xyzroe/Zintercom/images/z2m.png

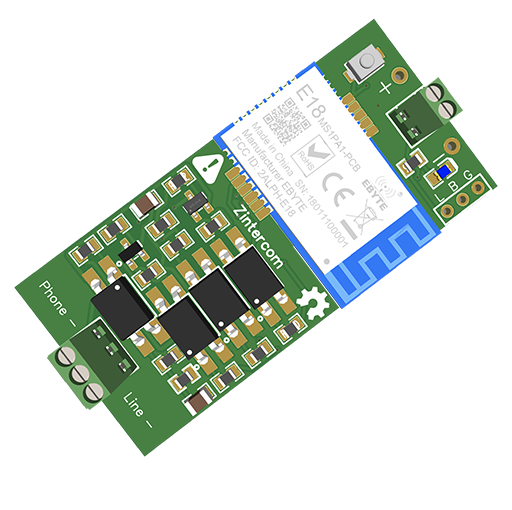
images/z2m.png
