xyzroe/Zintercom/hardware/BOM_Zintercom.csv

ID | Name | Designator | Footprint | Quantity | Manufacturer Part | Manufacturer | Supplier | Supplier Part | LCSC Assembly
1 | 22uF | C4 | CAP-SMD_L3.2-W1.6 | 1 | TCJR106M006R0500E | AVX | LCSC | C516053
2 | 10uF | C3 | CAP-SMD_L3.2-W1.6 | 1 | TCJR106M006R0500E | AVX | LCSC | C516053
3 | 120K | R12 | 0805 | 1 | RC0805FR-07120KL | YAGEO | LCSC | C114524
4 | BC817.215 | Q1 | SOT-23(SOT-23-3) | 1 | BC817,215 | Nexperia | LCSC | C8658
5 | 1K | R13 | R0805 | 1 | WR08X102JTL | WALSIN | LCSC | C163967
6 | 200K | R3 | R0805 | 1 | RC0402FR-07100KL | YAGEO | LCSC | C60491
7 | 470 | R4,R10,R11 | 0805 | 3 | RC0805FR-07470RL | YAGEO | LCSC | C114564
8 | 100 | R7 | 0805 | 1 | RC0805FR-07470RL | YAGEO | LCSC | C114564
9 | 10k | R2,R1 | 0805 | 2 | RC0805FR-07470RL | YAGEO | LCSC | C114564
10 | 50 | R6 | 0805 | 1 | RS-05K510JT | FH | LCSC | C139859
11 | KF128-2.54-3P | X1 | CONN-TH_3P-P2.54_KF128-2.54-3P | 1 | KF128-2.54-3P | Cixi Kefa Elec | LCSC | C474921
12 | LTV-817S-TA1-C | U2,U3,U4,U1 | OPTO-SMD-4_L4.6-W6.5-P2.54-LS10.3-BL | 4 | LTV-817S-TA1-C | LITEON | LCSC | C109227
13 | E18-MS1-PCB_domophone | E1 | E18-MS1PA1-PCB_DOMOPHONE | 1 | E18-MS1-PCB | Chengdu Ebyte Elec Tech | LCSC | C97344
14 | T.Switch3x4x2 | BTN | SWITCH-3.0*4.0 | 1 | T.Switch3x4x2 | ReliaPro |  | C26638
15 | AMS1117-3.3 | U5 | SOT-223-3_L6.5-W3.4-P2.30-LS7.0-BR | 1 | AMS1117-3.3 | AMS | LCSC | C6186 | Yes
16 | AAA HOLDER | B2 | AAA_HOLDER_NO_HOLE | 1
17 | 1u | C2,C1 | 0805 | 2
18 | KF128-2.54-2P | X2_0 | CONN-TH_P2.54_KF128-2.54-2P | 1 | KF128-2.54-2P | Cixi Kefa Elec | LCSC | C474920
19 | 2.54_5PIN | X3 | 1X5_PIN_HEADER_2.54MM | 1 | 2.54 4PIN
20 | LED0805 | LED | LED-0805 | 1
21 | 1K | R5 | 0805 | 1 | RC0805FR-071KL | YAGEO | LCSC | C95781
22 | 200 | R8,R9 | 0805 | 2 | RC0805FR-07200RL | YAGEO | LCSC | C114567
23 | BSS123 | Q2 | SOT-23-3_L2.9-W1.6-P1.90-LS2.8-BR | 1 | BSS123 | CJ | LCSC | C79015 | Yes
24 | 2.54-3P | X4 | 2.54-3P | 1
