xyzroe/Zintercom/(threads)

Thread 3 (2021-05-12):

Capacitors C3 and C4

BeardedTinker, 2021-05-12:
Can you please confirm/fix BOM for item 1 and 2 - they have same LCSC part number (10uF).

Thank you!

xyzroe, 2021-06-14:
Don't look at the part number, look at the name.
C3 - 10uF and C4 - 22uF

Closed 2021-06-14.

Thread 5 (2021-10-07):

Question: Why no opening switch in the module?

SAOPP, 2021-10-07:
Hi!

I'm playing with your module right now. Thanks for your work!

But I immediately had a question after connecting, why is the firmware not equipped with a switch that would send a signal to open?

Having looked at the diagram, I could not draw a conclusion for myself, I'm wondering why such an implementation is now, and what is missing for the opportunity to add this switch?

Thanks.

SAOPP, 2021-10-07:
Btw, I almost forgot, I'll write it down here, ideally, the following things are missing:

1. this is a switch opening out of the box in the firmware
2. these are the possibilities of soldering an external button on the board, for opening, for example, when there is a need to make button outside of the case or connect this button to existing button in intercom phone

I hope this will appear in the next versions of the firmware and the module itself, thanks in any case homie, a cool project, in particular, catch five for zigbee kehd. ;)

xyzroe, 2021-10-07:
1. This can be done with an external converter.
2. it is possible, see X4.  pin 1.2.
3. The LED displays the current mode anyway.  Read the description.

Closed 2021-10-07.

Thread 9 (2022-06-20):

Change the organization's logo

xyzroe, 2022-06-20:
Hello @kirovilya, @nurikk, @G1K

Could you change the organization’s logo? Because the Russian flag, and even more so with the military symbol, is currently unacceptable on it all over the world.

if this is unacceptable for you - please transfer this repository back to me as the original author, because I am forced to leave the organization with such symbols on logo.

G1K, 2022-06-20:
I'm not the owner of the organization, but I don't mind. However, I do not understand of course what to replace the letter, which in this direction symbolizes zigbee.

xyzroe, 2022-06-20:
Probably to avoid doublethink use the whole word Zigbee or short Zig

kirovilya, 2022-06-20:
Hello. I didn't think that the Zigbee symbol would have a negative meaning.
The original name DiyRuZ meant the Russian-speaking DIY-Zigbee-community. And at the time of the appearance, the picture meant exactly that and nothing else.
I understand that now this combination will be a trigger for some users.
Alternatively, I can remove the coloring, leaving the rest of the elements the same.
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

xyzroe, 2022-06-20:
But given that this symbol is used in military propaganda, it should be replaced.

It's not about triggering some users, it's about if you call the community **_Russian-speaking_**, let's remove the flag - make the logo really politically **neutral**.
Even in gray, this is the same flag - the **aggressor** state.

Why not use a bee, like one of the well-known software, but in combination with DIY?

nurikk, 2022-06-21:
Agree on point that aggressor state flag should be taken down. But not agree on letter z, it's taken straight away from [Zigbee Alliance Trademark and Logo Usage Guidelines and Terms](https://zigbeealliance.org/wp-content/uploads/2019/12/Zigbee-Alliance-Trademark-and-Logo-Usage-Guidelines-and-Terms.pdf). Don't let this fuckers to take away letter z from you, even if they're using it for propaganda.

The proposed logo above is already good enough :)

xyzroe, 2022-06-21:
If we refer to the Zigbee Alliance Trademark and Logo Usage Guidelines and Terms, let's use the original logo. Without any political elements.
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

kirovilya, 2022-06-21:
how about a flatter logo?
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

xyzroe, 2022-06-21:
Thank you all for the objective assessment of what is happening!

kirovilya, 2022-06-22:
Other community members wrote to me that they were outraged by the change in logo and transition to neutral colors, citing political motives for such a decision. I'm bringing back the old logo.

nurikk, 2022-06-22:
> Other community members wrote to me that they were outraged by the change in logo and transition to neutral colors, citing political motives for such a decision. I'm bringing back the old logo.

Who are this members? Do the contribute in open source Zigbee?

nurikk, 2022-06-22:
There are 4 members  in this  organisation, I don’t see any outrage in this conversation

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

kirovilya, 2022-06-22:
not the authors of the firmware, but those who use these firmware, make devices with them.

xyzroe, 2022-06-22:
If you want to politicize on GitHub, please transfer the Zintercom repo to my account, please, and stay with your logo rag.

kirovilya, 2022-06-22:
@xyzroe I gave admin rights - now you can transfer the repository to yourself. I can't do it myself

xyzroe, 2022-06-22:
> not the authors of the firmware, but those who use these firmware, make devices with them.

 Ilya, you act like a chick who gives opinion twice a day, yesterday you had no contradictions with changing logo.

 And for users who do not even contribute to open source software, but want to dictate the rules - start with your contribution, and then tell others how to act.

xyzroe, 2022-06-22:
@nurikk Thanks for being objective.

kolbertv, 2022-06-22:
> If you want to politicize on GitHub, please transfer the Zintercom repo to my account, please, and stay with your logo rag.

Ты сам политикой занимаешься в гитхабе судя по твоему аккаунту. Так что  не надо других обвинять.

xyzroe, 2022-06-22:
> > If you want to politicize on GitHub, please transfer the Zintercom repo to my account, please, and stay with your logo rag.
>
> Ты сам политикой занимаешься в гитхабе судя по твоему аккаунту. Так что не надо других обвинять.

I forgot to ask you, pigdog.

kolbertv, 2022-06-22:
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

Поросенок микола, не бомби.)

Closed 2022-06-22.

Thread 10 (2022-12-03):

Lost network in during work z2m version 1.28.4

TimpP-Spb, 2022-12-03:
Hi,

I meet with one problem, Zintercom lost connection after 2 minutes, and in Home Asisstnt will be Not avaibale.
What I must check or what i can do for normal work?

xyzroe, 2023-08-14:
Try to reconfigure the device, or manually set up reporting and binding.

Closed 2023-08-14.

Thread 11 (2023-04-05):

battery power

maddron, 2023-04-05:
hey!
When powered by a battery, the device must always be in sleep mode. But somehow it turned out that the device immediately responded about changing the mode (never, once, drop). It was very convenient, even despite the increased battery consumption.
After replacing the battery, the device is constantly in sleep mode (as per the instructions).

Is there a way to put it into a state so that it responds to the mode change immediately? Or it was a bug or smth?

xyzroe, 2023-04-12:
Hello!
As far as I know, the device may not go into sleep mode if reporting is not configured / the interview has not completely passed. Perhaps you have had one of these cases.

In sleep mode, a change in the reporting interval is available, and it seems to me that if you set it to 0 minutes, then it will not go into sleep mode.

Closed 2023-08-14.

Thread 12 (2023-08-14):

Can't repair Zintercom

DejavuDmitry, 2023-08-14:
After deleting device from z2m I just can't pair it again.
I was trying to press changing mode button for more than 5 seconds (didn't work), also resetting the power for 5 times, nothing changes.
What I must do for positive result?
Thanks.

xyzroe, 2023-08-14:
There are only two ways to reset the device to factory settings. You have tried both.
You can also try to reflash the device, but this is unlikely to help.

There may be a problem with your network, so the device is not connecting.

Closed 2023-08-14.

Thread 13 (2023-12-19):

Problems with converter

brutevinch, 2023-12-19:
In dev version zigbee2mqtt we get this:
zigbee  | Zigbee2MQTT:error 2023-12-19 13:31:01: Failed to load external converter file 'converters/DIYRuZ_Zintercom.js' (Cannot read properties of undefined (reading 'presets'))
zigbee  | Zigbee2MQTT:error 2023-12-19 13:31:01: Probably there is a syntax error in the file or the external converter is not compatible with the current Zigbee2MQTT version
zigbee  | Zigbee2MQTT:error 2023-12-19 13:31:01: Note that external converters are not meant for long term usage, it's meant for local testing after which a pull request should be created to add out-of-the-box support for the device

looks like need some fixes.

xyzroe, 2023-12-19:
https://xyzroe.cc/ZigUSB/
Have you tried new one?

xyzroe, 2023-12-19:
Sorry,

xyzroe, 2023-12-19:
https://www.zigbee2mqtt.io/devices/DIYRuZ_Zintercom.html

Zintercom should work without any converter.

Thread 14 (2024-02-26):

The device does not open the intercom.

dgerk15, 2024-02-26:
Hello, thanks for the cool device!

Unfortunately, I ran into a problem, the purchased device does not open the intercom, as well as the device does not switch to silent mode.

I have only 2 modes working, these are "never" and "drop".

1. In the "never" mode, I receive a call on the intercom and can open it with the intercom button. If I press the button on the device, the intercom does not open.

2. In the "drop" mode, when you call the intercom, there is a reset, everything is fine here.

3. In the "once" and "always" modes, the device picks up the phone, but does not open the intercom.

4. When I turn off the sound mode, I still get a call on the handset.

Please help me figure out my problem, thanks in advance!

------

p.s: In the z2m logs, I see a change in the status of the device, there is no opening. I attached the settings from z2m, maybe they will help.
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

dgerk15, 2024-02-26:
Thanks a lot for the answer, I will try.
Can I write to you here in case of success/failure?

P/s immediately wrote to you, as I am sure that the device changes its states when interacting with the intercom (I see state changes to ring, talk, open). From this, I concluded that the device is working well, and I can assume that there is some kind of trouble in my settings.

Closed 2025-04-08.
