xyzroe/Zintercom/(commit log)

2020-12-27 added pcbs' renders
2020-12-28 enabled ADC calculation
2021-01-02 added schematic
2021-01-15 fixed the work of inputs and outputs on the target board (button and call) implemented sleep mode in battery mode (end device) power attributes are always advertised, (used only in battery mode) impl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
    [OSAL_App.c, hal_board_cfg.h, preinclude.h, zcl_app.c, zcl_app.h, zcl_app_data.c]
2021-01-15 v0.1
    fixed the work of inputs and outputs on the target board (button and call)
    implemented sleep mode in battery mode (end device)
    power attributes are always advertised, (used only in battery mode)
    implemented bind to another device (notify about a call to the intercom)
    minor changes in the code (syntactic)
    [OSAL_App.c, hal_board_cfg.h, preinclude.h, zcl_app.c, zcl_app.h, zcl_app_data.c]
2021-01-15 PCB v0.1
    updated scheme (BTN pin)
    added Gerber and BOM files
    updated images
    [BOM_Zintercom.csv]
2021-02-16 some rework
    reworked the sequence and conditions of optocouplers triggering;
    clarified the name of the configurations;
    [zcl_app.c, zcl_app.h]
2021-02-16 output pin renamed
2021-02-22 R7 changed to 200 ohm
    [BOM_Zintercom.csv]
2021-02-22 Schematic_Zintercom.png fixed
2021-03-23 v0.2
    some code rework and cleanup
    R7 changed to 100 ohm
    converter exposes renamed
    [BOM_Zintercom.csv]
2021-03-23 fixed drop while ring added z2m dashboard screens
    [zcl_app.c, zcl_app_data.c]
2021-04-14 hardware PCB v1.0
    [BOM_Zintercom.csv]
2021-04-15 updated readme `battery mode` part updated external converter updated some images
2021-04-22 trying to add long press button event
2021-06-14 Some major fixes: 1. Fixed a call detecting mechanism, which led to a call cliff during a conversation or opening the door, which sometimes prevented open the door. (In some cases, it did not open at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
    [preinclude.h, zcl_app.c]
2021-06-14 Update README.md
    Added:
    1. Error description about Gerber PCB v1.0 committed on Apr 14
    2. Image and link to the 3d model of the case.
2021-06-15 events' timers reworked
2022-02-12 fix button hold
2022-02-16 Add RGB led support Rework button actions (single, double, hold) Detail description can be found in hardware/Домофон zintercom.docx
    [hal_board_cfg.h, preinclude.h, zcl_app.c, zcl_app.h]
2022-02-16 Add binary switches for different modes
2022-02-20 set old led
2022-02-25 RGB and UART works
2022-03-05 remove led timer
2022-03-13 fix button press
2022-03-15 support battery and old LED
2022-04-25 Open and Drop by button and command
